misaz/Elector-Contest-Solar-Sensor/11_sensor_sch/SolarTemperatureSensor.pdf

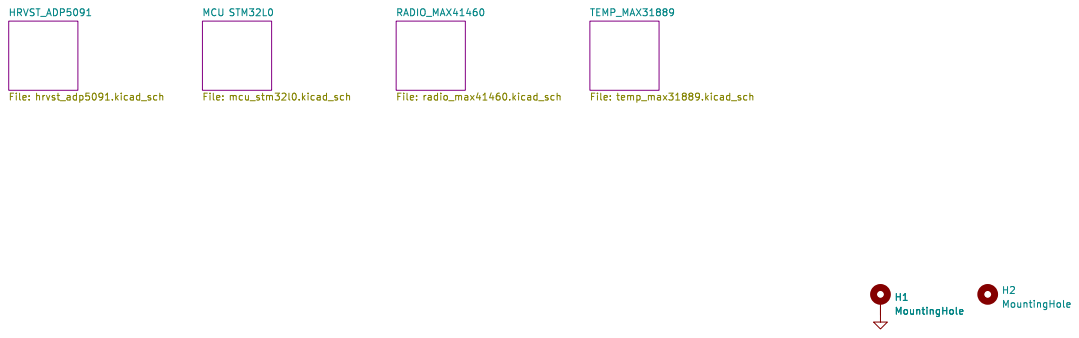
[picture p1: page 1]

Id: 1/5 Title: File: SolarTemperatureSensor.kicad_sch Sheet: /

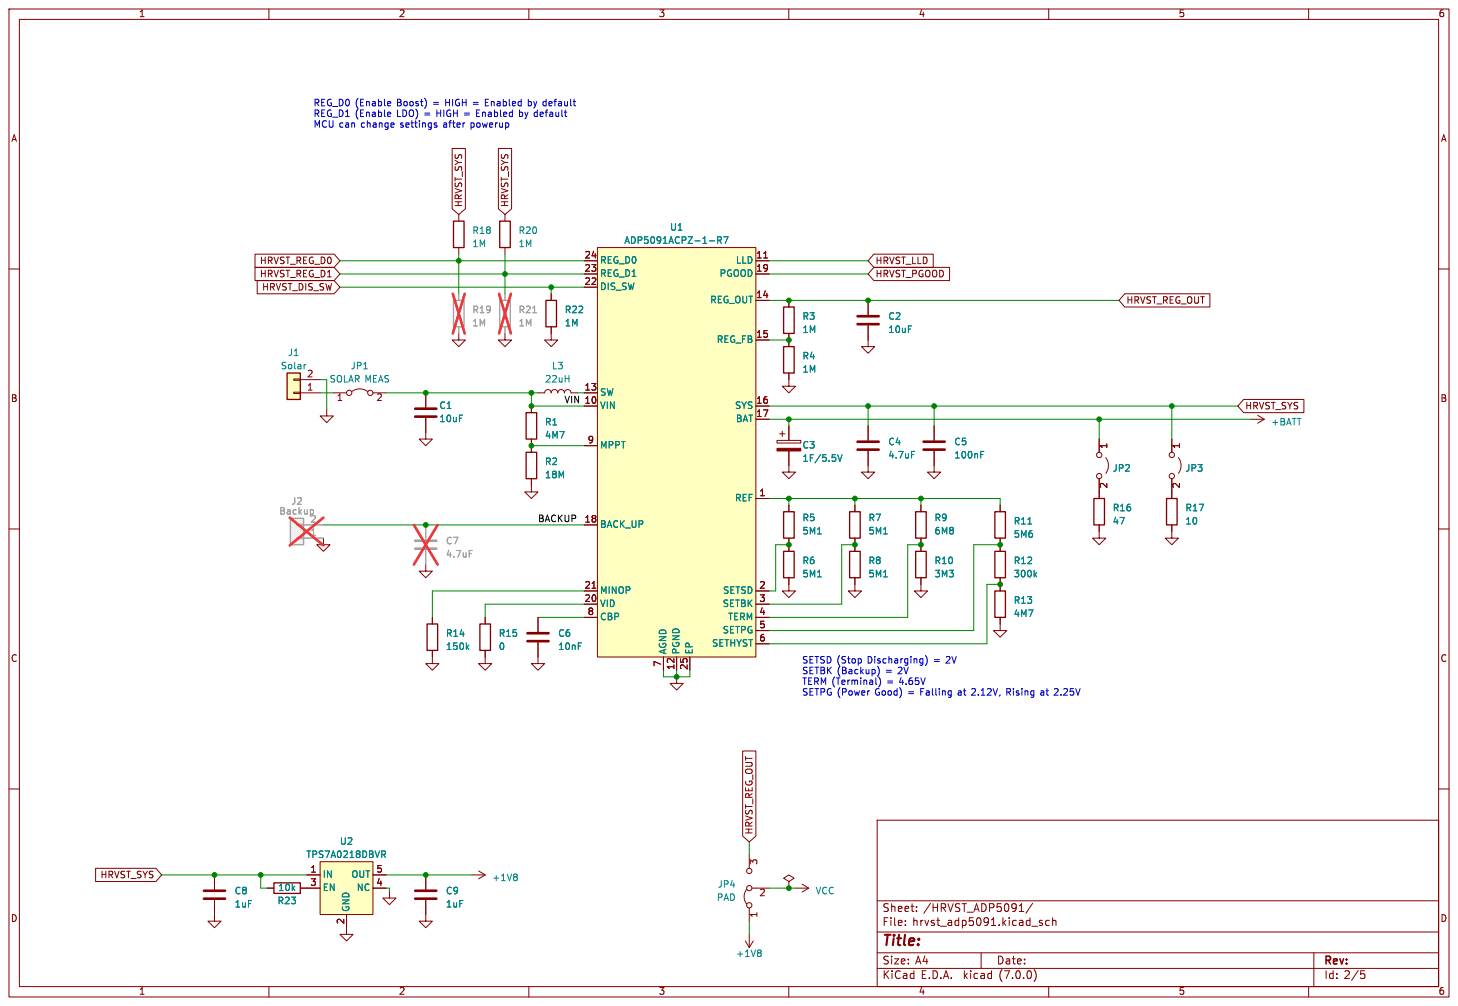
[picture p2: page 2]

SETPG (Power Good) = Falling at 2.12V, Rising at 2.25V R3

Id: 2/5 Title: File: hrvst_adp5091.kicad_sch Sheet: /HRVST_ADP5091/

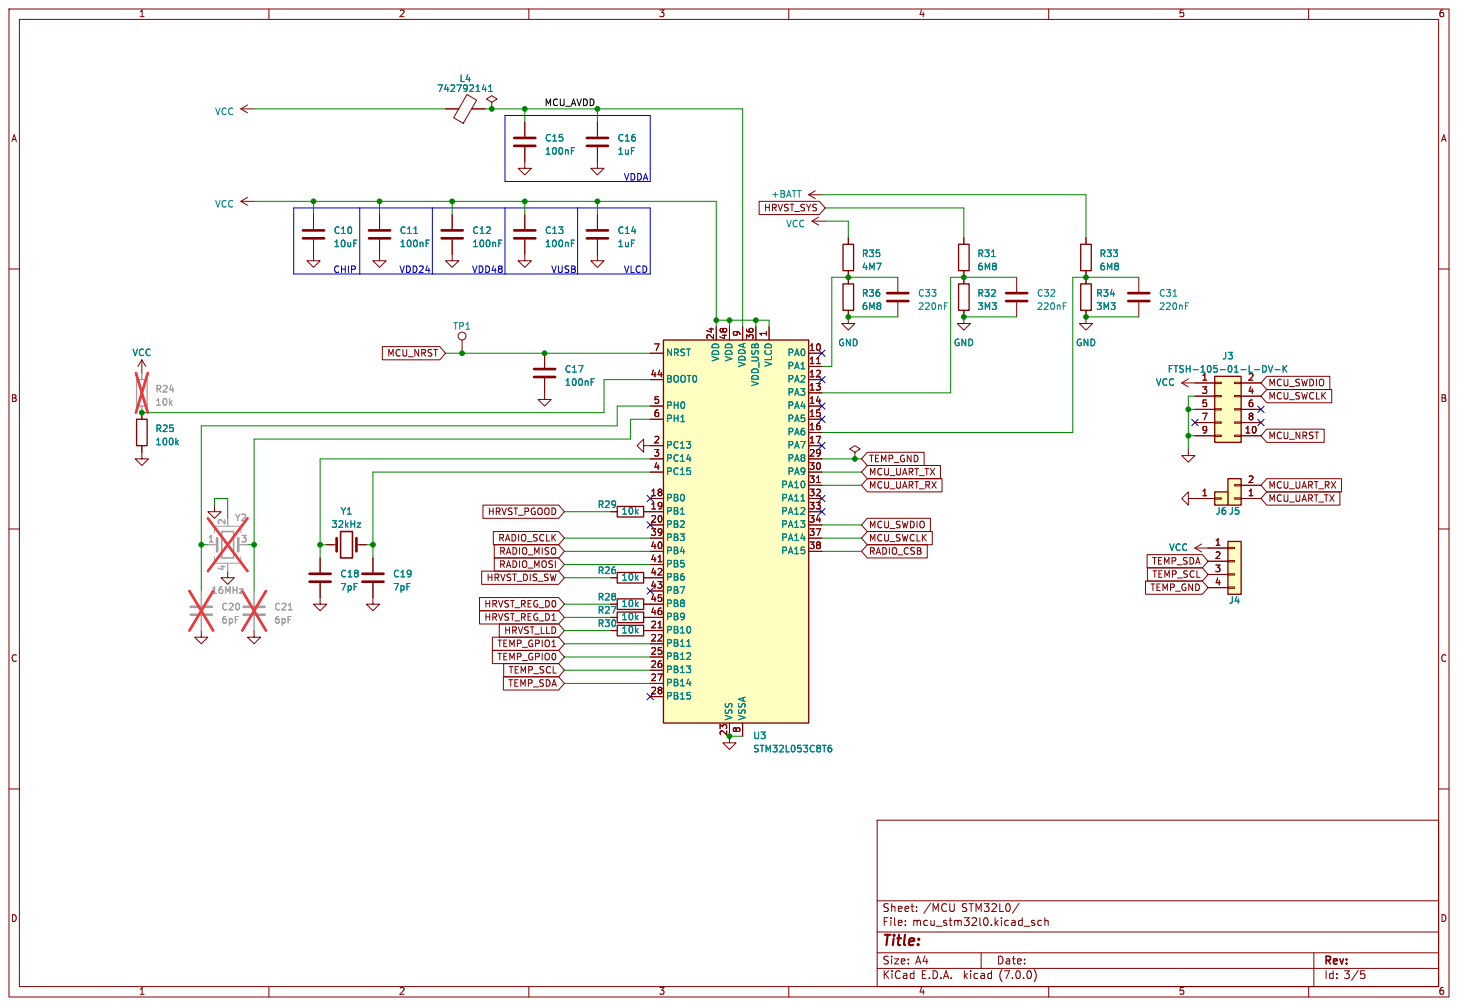
[picture p3: page 3]

1 PA0 10 PA1 11 PA2 12 PA3 13 PA4 14 PA5 15 PA6 16 PA7 17 PB0 18 PB1 19 PC13 2 PB2 20 PB10 21 PB11 22 VSS 23 VDD 24 PB12 25 PB13 26 PB14 27 PB15 28 PA8 29 PC14 3 PA9 30 PA10 31 PA11 32 PA12 33 PA13 34 VDD_USB 36 PA14 37 PA15 38 PB3 39 PC15 4 PB4 40 PB5 41 PB6 42 PB7 43 BOOT0 44 PB8 45 PB9 46 VDD 48 PH0 5 PH1 6 NRST 7 VSSA

Id: 3/5 Title: File: mcu_stm32l0.kicad_sch Sheet: /MCU STM32L0/ Y1

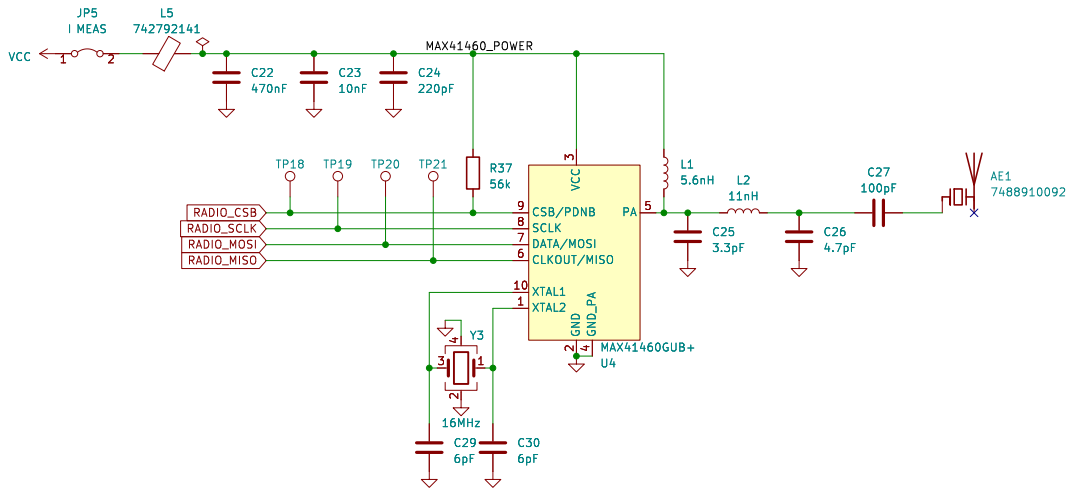
[picture p4: page 4]

4 PA 5 CLKOUT/MISO 6 DATA/MOSI 7 SCLK 8 CSB/PDNB 9 U4 MAX41460GUB+ C25

4 PA 5 CLKOUT/MISO 6 DATA/MOSI 7 SCLK 8 CSB/PDNB 9 C25

Id: 4/5 Title: File: radio_max41460.kicad_sch Sheet: /RADIO_MAX41460/

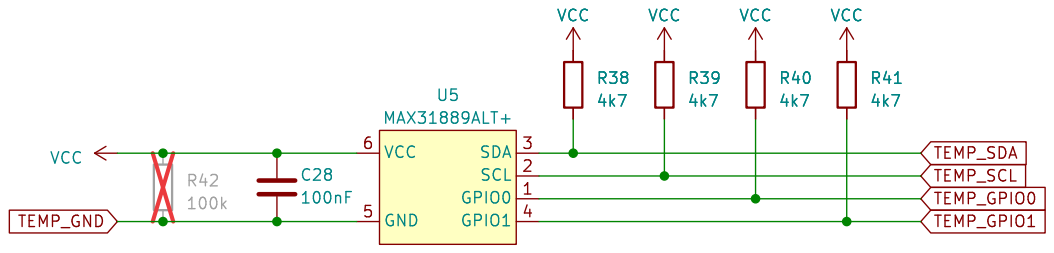
[picture p5: page 5]

Id: 5/5 Title: File: temp_max31889.kicad_sch Sheet: /TEMP_MAX31889/
