misaz/Elector-Contest-Solar-Sensor/10_sensor_kicad/SolarTemperatureSensor.kicad_pcb

## KiCad design 10_sensor_kicad/SolarTemperatureSensor.kicad_pcb (2024-03-01)

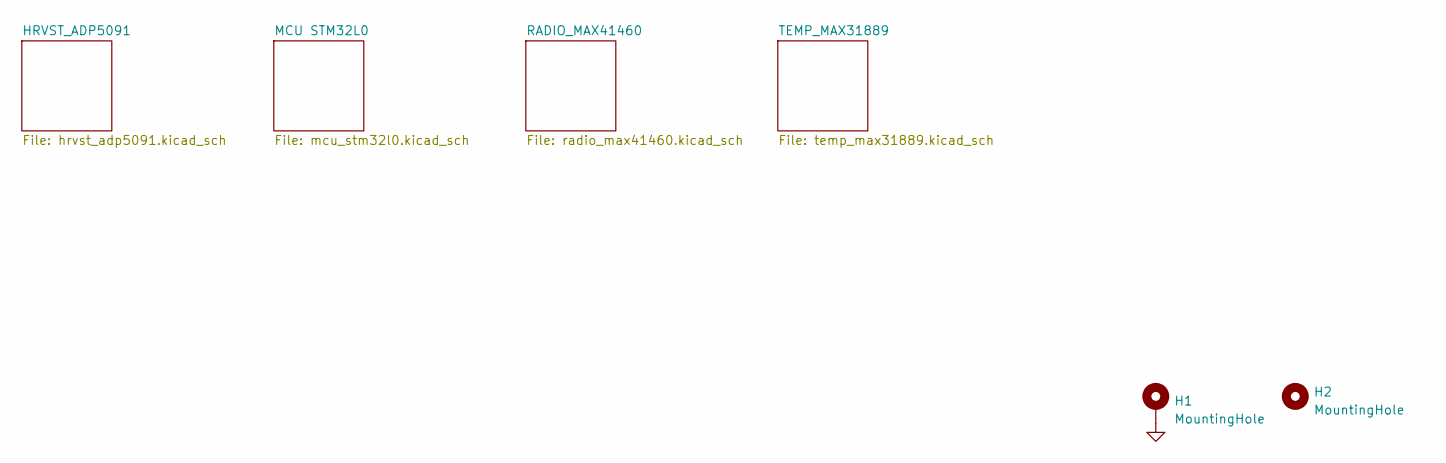
[picture p6: schematic SolarTemperatureSensor.kicad_sch]

Parts:
H1: MountingHole; MountingHole_3.5mm_Pad
H2: MountingHole; MountingHole_3.5mm

Connections:
GND: H1.1; also elsewhere on the board

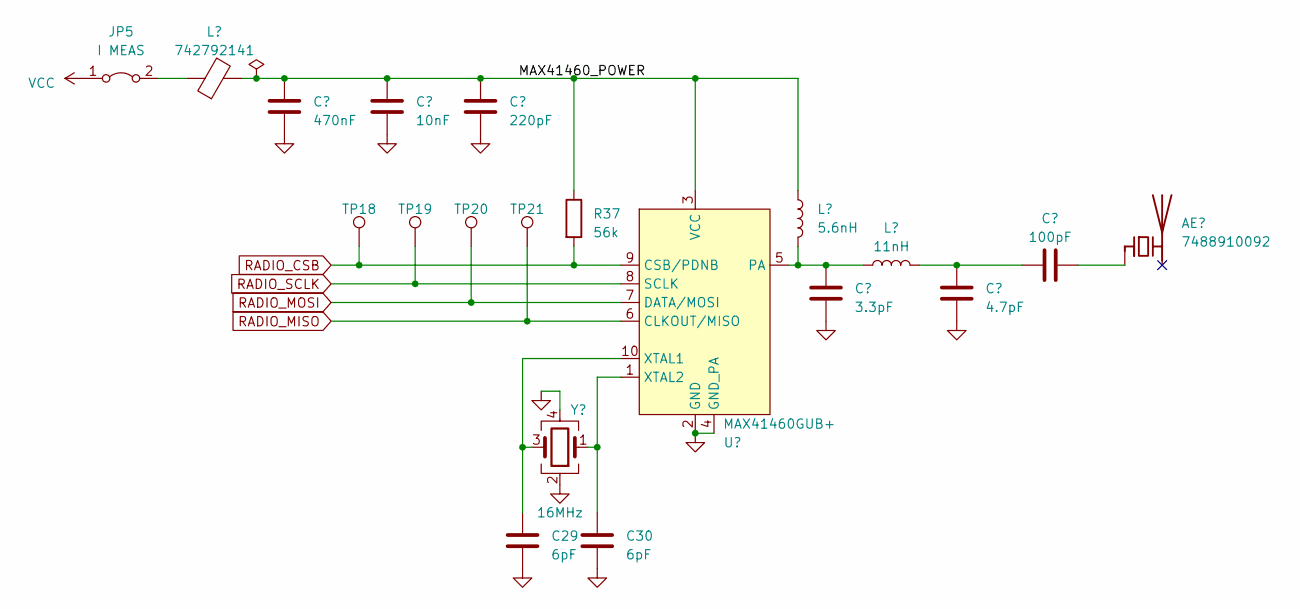
[picture p7: schematic radio_max41460.kicad_sch]

Parts:
AE1: 7488910092
C22: 470nF; C_0603_1608Metric_Pad1.08x0.95mm_HandSolder
C23: 10nF; C_0603_1608Metric_Pad1.08x0.95mm_HandSolder
C24: 220pF; C_0603_1608Metric_Pad1.08x0.95mm_HandSolder
C25: 3.3pF; C_0805_2012Metric_Pad1.18x1.45mm_HandSolder
C26: 4.7pF; C_0805_2012Metric_Pad1.18x1.45mm_HandSolder
C27: 100pF; C_0805_2012Metric_Pad1.18x1.45mm_HandSolder
C29, C30: 6pF; C_0805_2012Metric
JP5: I MEAS; PinHeader_1x02_P2.54mm_Vertical
L1: 5.6nH; L_0603_1608Metric_Pad1.05x0.95mm_HandSolder
L2: 11nH; L_0603_1608Metric_Pad1.05x0.95mm_HandSolder
L5: 742792141; L_1206_3216Metric
R37: 56k; R_0603_1608Metric_Pad0.98x0.95mm_HandSolder
TP18, TP19, TP20, TP21: TestPoint; TestPoint_Pad_D1.0mm
U4: MAX41460GUB+; MAX41460
Y3: 16MHz; Crystal_SMD_2016-4Pin_2.0x1.6mm

Connections:
/RADIO_MAX41460/MAX41460_POWER: C22.1, C23.1, C24.1, L1.1, L5.2, R37.1, U4.3 (VCC)
GND: C22.2, C23.2, C24.2, C25.2, C26.2, C29.2, C30.2, U4.2 (GND), U4.4 (GND_PA), Y3.2, Y3.4; also elsewhere on the board
unnamed: AE1.1 (FEED), C27.2
unnamed: C26.1, C27.1, L2.2
unnamed: JP5.2 (B), L5.1
unnamed: C25.1, L1.2, L2.1, U4.5 (PA)
unnamed: C29.1, U4.10 (XTAL1), Y3.3
unnamed: C30.1, U4.1 (XTAL2), Y3.1
RADIO_CSB: R37.2, TP18.1, U4.9 (CSB/PDNB); also elsewhere on the board
RADIO_MISO: TP21.1, U4.6 (CLKOUT/MISO); also elsewhere on the board
RADIO_MOSI: TP20.1, U4.7 (DATA/MOSI); also elsewhere on the board
RADIO_SCLK: TP19.1, U4.8 (SCLK); also elsewhere on the board
VCC: JP5.1 (A); also elsewhere on the board

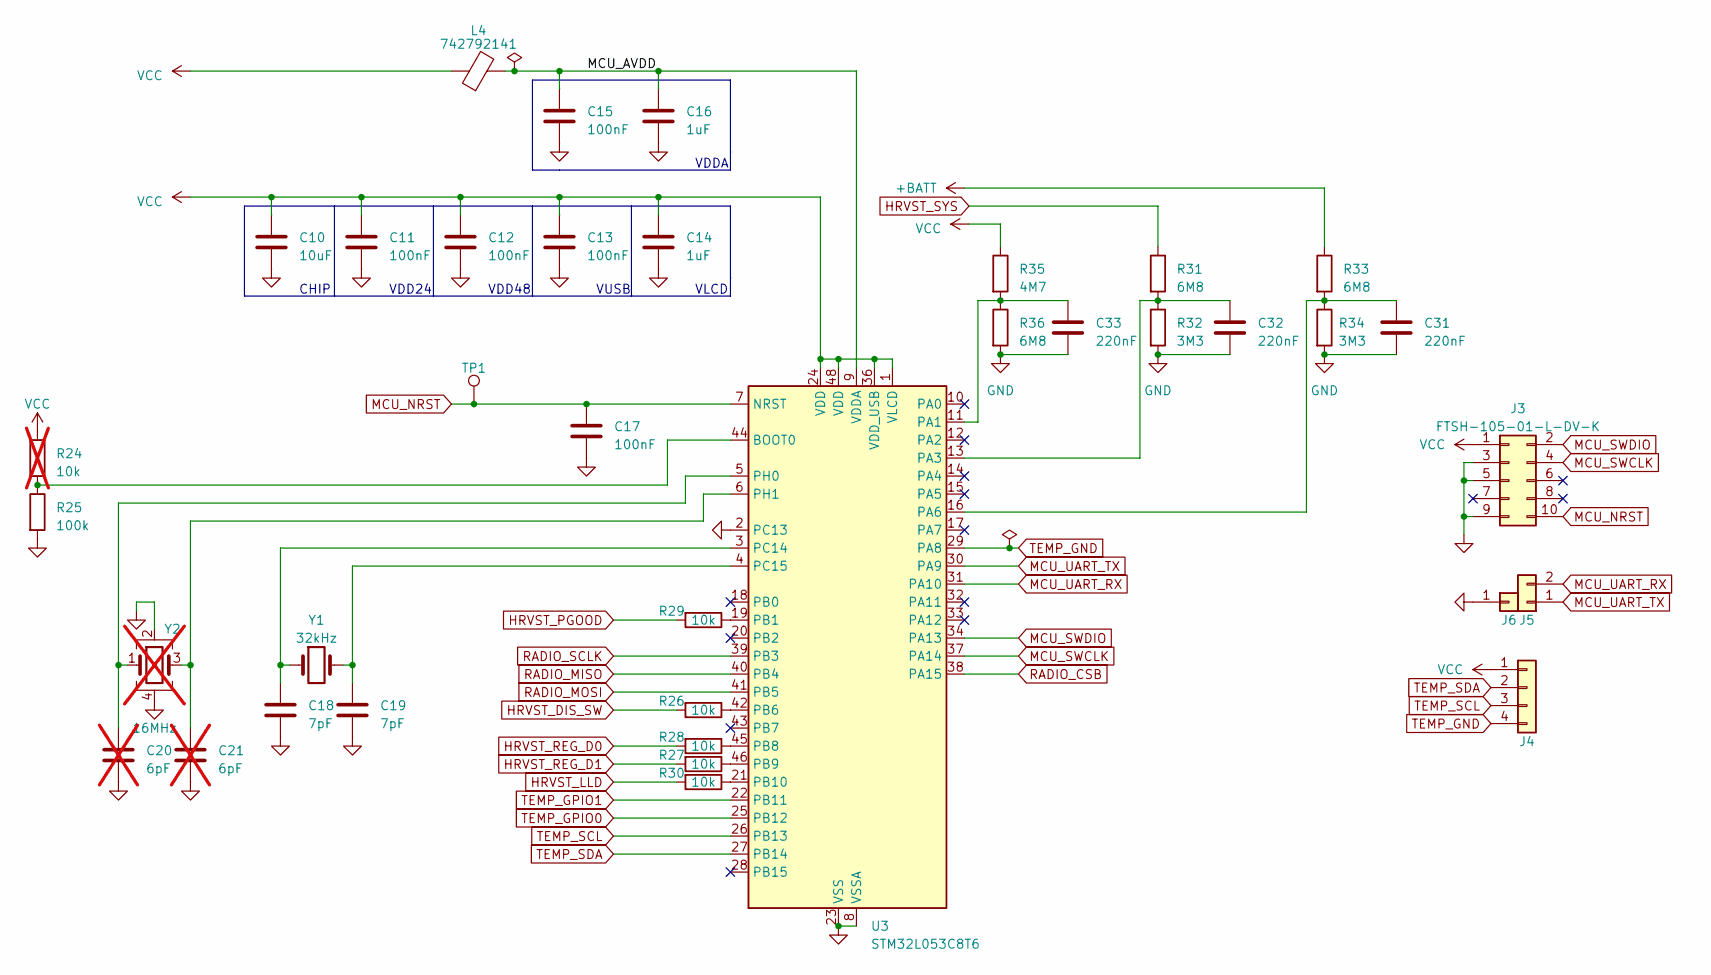
[picture p8: schematic mcu_stm32l0.kicad_sch]

Parts:
C10: 10uF; C_0603_1608Metric_Pad1.08x0.95mm_HandSolder
C11, C12, C13, C15, C17: 100nF; C_0603_1608Metric_Pad1.08x0.95mm_HandSolder
C14, C16: 1uF; C_0603_1608Metric_Pad1.08x0.95mm_HandSolder
C18, C19: 7pF; C_0805_2012Metric
C20, C21: 6pF; C_0805_2012Metric; not fitted
C31, C32, C33: 220nF
J3: FTSH-105-01-L-DV-K; SAMTEC_FTSH-105-XX-X-DV
J4: Conn_01x04; PinHeader_1x04_P2.54mm_Vertical
J5: Conn_01x02; PinHeader_1x02_P2.54mm_Vertical
J6: Conn_01x01; PinHeader_1x01_P2.54mm_Vertical
L4: 742792141; L_1206_3216Metric
R24: 10k; R_0603_1608Metric_Pad0.98x0.95mm_HandSolder; not fitted
R25: 100k; R_0603_1608Metric_Pad0.98x0.95mm_HandSolder
R26, R27, R28, R29, R30: 10k; R_0603_1608Metric_Pad0.98x0.95mm_HandSolder
R31, R33, R36: 6M8; R_0603_1608Metric_Pad0.98x0.95mm_HandSolder
R32, R34: 3M3; R_0603_1608Metric_Pad0.98x0.95mm_HandSolder
R35: 4M7; R_0603_1608Metric_Pad0.98x0.95mm_HandSolder
TP1: TestPoint; TestPoint_Pad_D1.0mm
U3: STM32L053C8T6; LQFP-48_7x7mm_P0.5mm
Y1: 32kHz; Crystal_SMD_3215-2Pin_3.2x1.5mm
Y2: 16MHz; Crystal_SMD_2016-4Pin_2.0x1.6mm; not fitted

Connections:
+BATT: R33.1; also elsewhere on the board
/MCU STM32L0/MCU_AVDD: C15.1, C16.1, L4.2, U3.9 (VDDA)
GND: C10.2, C11.2, C12.2, C13.2, C14.2, C15.2, C16.2, C17.2, C18.2, C19.2, C20.2, C21.2, C31.2, C32.2, C33.2, J3.3, J3.5, J3.9, J6.1, R25.2, R32.2, R34.2, R36.2, U3.2 (PC13), U3.8 (VSSA), U3.23 (VSS), U3.35 (VSS), U3.47 (VSS), Y2.2, Y2.4; also elsewhere on the board
HRVST_DIS_SW: R26.2; also elsewhere on the board
HRVST_LLD: R30.2; also elsewhere on the board
HRVST_PGOOD: R29.2; also elsewhere on the board
HRVST_REG_D0: R28.2; also elsewhere on the board
HRVST_REG_D1: R27.2; also elsewhere on the board
HRVST_SYS: R31.1; also elsewhere on the board
MCU_NRST: C17.1, J3.10, TP1.1, U3.7 (NRST)
MCU_SWCLK: J3.4, U3.37 (PA14)
MCU_SWDIO: J3.2, U3.34 (PA13)
MCU_UART_RX: J5.2, U3.31 (PA10)
MCU_UART_TX: J5.1, U3.30 (PA9)
unnamed: R24.2, R25.1, U3.44 (BOOT0)
unnamed: C33.1, R35.2, R36.1, U3.11 (PA1)
unnamed: C32.1, R31.2, R32.1, U3.13 (PA3)
unnamed: C31.1, R33.2, R34.1, U3.16 (PA6)
unnamed: R29.1, U3.19 (PB1)
unnamed: R26.1, U3.42 (PB6)
unnamed: R28.1, U3.45 (PB8)
unnamed: R27.1, U3.46 (PB9)
unnamed: R30.1, U3.21 (PB10)
unnamed: C18.1, U3.3 (PC14), Y1.1
unnamed: C19.1, U3.4 (PC15), Y1.2
unnamed: C20.1, U3.5 (PH0), Y2.1
unnamed: C21.1, U3.6 (PH1), Y2.3
RADIO_CSB: U3.38 (PA15); also elsewhere on the board
RADIO_MISO: U3.40 (PB4); also elsewhere on the board
RADIO_MOSI: U3.41 (PB5); also elsewhere on the board
RADIO_SCLK: U3.39 (PB3); also elsewhere on the board
TEMP_GND: J4.4, U3.29 (PA8); also elsewhere on the board
TEMP_GPIO0: U3.25 (PB12); also elsewhere on the board
TEMP_GPIO1: U3.22 (PB11); also elsewhere on the board
TEMP_SCL: J4.3, U3.26 (PB13); also elsewhere on the board
TEMP_SDA: J4.2, U3.27 (PB14); also elsewhere on the board
VCC: C10.1, C11.1, C12.1, C13.1, C14.1, J3.1, J4.1, L4.1, R24.1, R35.1, U3.1 (VLCD), U3.24 (VDD), U3.36 (VDD_USB), U3.48 (VDD); also elsewhere on the board

Notes on the sheet:
VDD48
CHIP
VUSB
VDD24
VLCD
VDDA

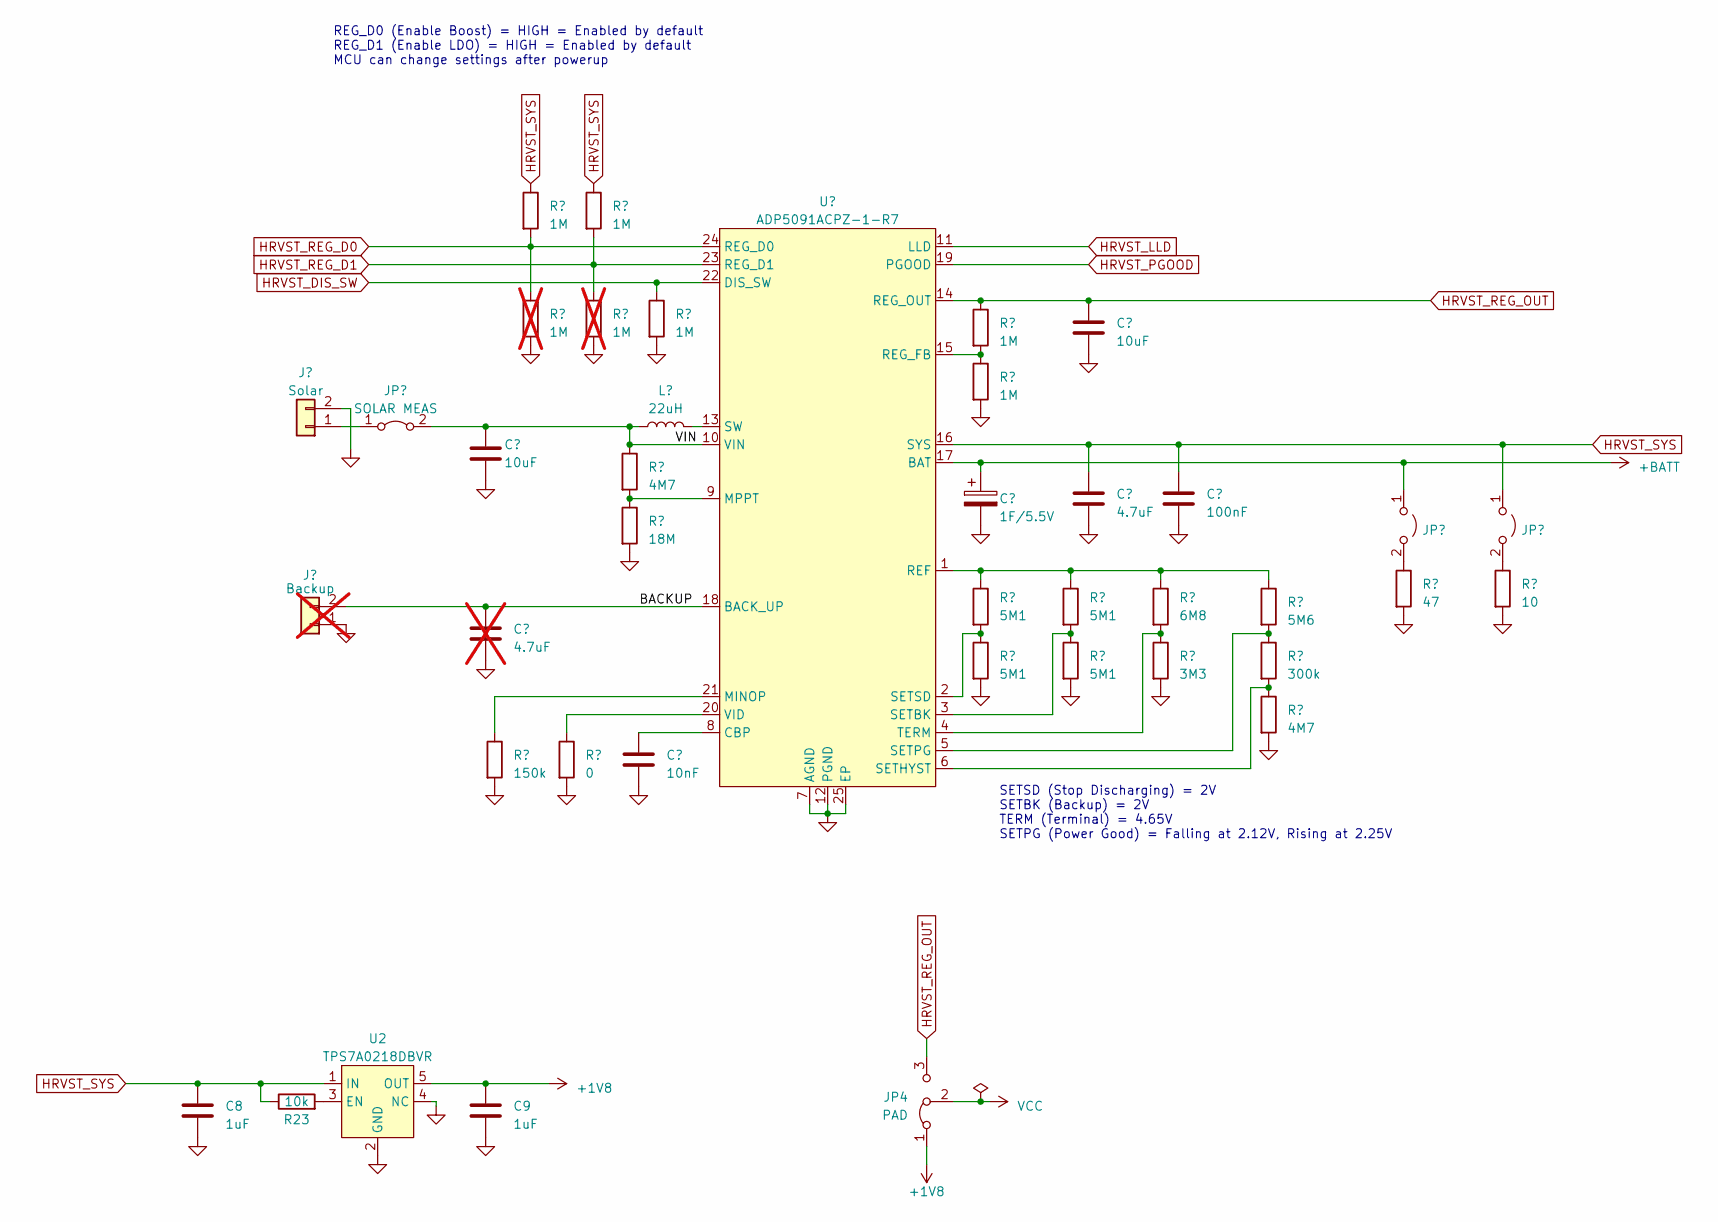
[picture p9: schematic hrvst_adp5091.kicad_sch]

Parts:
C1, C2: 10uF; C_0603_1608Metric_Pad1.08x0.95mm_HandSolder
C3: 1F/5.5V; SCMR18C105PRBA0
C4: 4.7uF; C_0603_1608Metric_Pad1.08x0.95mm_HandSolder
C5: 100nF; C_0603_1608Metric_Pad1.08x0.95mm_HandSolder
C6: 10nF; C_0603_1608Metric_Pad1.08x0.95mm_HandSolder
C7: 4.7uF; C_0603_1608Metric_Pad1.08x0.95mm_HandSolder; not fitted
C8, C9: 1uF; C_0603_1608Metric_Pad1.08x0.95mm_HandSolder
J1: Solar; VN02A1500000G
J2: Backup; VN02A1500000G; not fitted
JP1: SOLAR MEAS; PinHeader_1x02_P2.54mm_Vertical
JP2, JP3: BAT DISCHARGE; PinHeader_1x02_P2.54mm_Vertical
JP4: PAD; SolderJumper-3_P1.3mm_Open_RoundedPad1.0x1.5mm
L3: 22uH; DJNR6045
R1, R13: 4M7; R_0603_1608Metric_Pad0.98x0.95mm_HandSolder
R2: 18M; R_0603_1608Metric_Pad0.98x0.95mm_HandSolder
R3, R4, R18, R20, R22: 1M; R_0603_1608Metric_Pad0.98x0.95mm_HandSolder
R5, R6, R7, R8: 5M1; R_0603_1608Metric_Pad0.98x0.95mm_HandSolder
R9: 6M8; R_0603_1608Metric_Pad0.98x0.95mm_HandSolder
R10: 3M3; R_0603_1608Metric_Pad0.98x0.95mm_HandSolder
R11: 5M6; R_0603_1608Metric_Pad0.98x0.95mm_HandSolder
R12: 300k; R_0603_1608Metric_Pad0.98x0.95mm_HandSolder
R14: 150k; R_0603_1608Metric_Pad0.98x0.95mm_HandSolder
R15: 0; R_0603_1608Metric_Pad0.98x0.95mm_HandSolder
R16: 47; R_0603_1608Metric_Pad0.98x0.95mm_HandSolder
R17: 10; R_0603_1608Metric_Pad0.98x0.95mm_HandSolder
R19, R21: 1M; R_0603_1608Metric_Pad0.98x0.95mm_HandSolder; not fitted
R23: 10k; R_0603_1608Metric_Pad0.98x0.95mm_HandSolder
U1: ADP5091ACPZ-1-R7; ADP5091ACPZ-1-R7_ADI-M
U2: TPS7A0218DBVR; SOT-23-5_HandSoldering

Connections:
+1V8: C9.1, JP4.1 (A), U2.5 (OUT)
+BATT: C3.1, JP2.1 (A), U1.17 (BAT); also elsewhere on the board
/HRVST_ADP5091/BACKUP: C7.1, J2.2, U1.18 (BACK_UP)
/HRVST_ADP5091/VIN: C1.1, JP1.2 (B), L3.1, R1.1, U1.10 (VIN)
GND: C1.2, C2.2, C3.2, C4.2, C5.2, C6.2, C7.2, C8.2, C9.2, J1.2, J2.1, R2.2, R4.2, R6.2, R8.2, R10.2, R13.2, R14.2, R15.2, R16.2, R17.2, R19.2, R21.2, R22.2, U1.7 (AGND), U1.12 (PGND), U1.25 (EP), U2.2 (GND), U2.4 (NC); also elsewhere on the board
HRVST_DIS_SW: R22.1, U1.22 (DIS_SW); also elsewhere on the board
HRVST_LLD: U1.11 (LLD); also elsewhere on the board
HRVST_PGOOD: U1.19 (PGOOD); also elsewhere on the board
HRVST_REG_D0: R18.2, R19.1, U1.24 (REG_D0); also elsewhere on the board
HRVST_REG_D1: R20.2, R21.1, U1.23 (REG_D1); also elsewhere on the board
HRVST_REG_OUT: C2.1, JP4.3 (B), R3.1, U1.14 (REG_OUT)
HRVST_SYS: C4.1, C5.1, C8.1, JP3.1 (A), R18.1, R20.1, R23.1, U1.16 (SYS), U2.1 (IN); also elsewhere on the board
unnamed: J1.1, JP1.1 (A)
unnamed: JP2.2 (B), R16.1
unnamed: JP3.2 (B), R17.1
unnamed: C6.1, U1.8 (CBP)
unnamed: R14.1, U1.21 (MINOP)
unnamed: R1.2, R2.1, U1.9 (MPPT)
unnamed: R5.1, R7.1, R9.1, R11.1, U1.1 (REF)
unnamed: R3.2, R4.1, U1.15 (REG_FB)
unnamed: R7.2, R8.1, U1.3 (SETBK)
unnamed: R12.2, R13.1, U1.6 (SETHYST)
unnamed: R11.2, R12.1, U1.5 (SETPG)
unnamed: R5.2, R6.1, U1.2 (SETSD)
unnamed: L3.2, U1.13 (SW)
unnamed: R9.2, R10.1, U1.4 (TERM)
unnamed: R15.1, U1.20 (VID)
unnamed: R23.2, U2.3 (EN)
VCC: JP4.2 (C); also elsewhere on the board

Notes on the sheet:
SETSD (Stop Discharging) = 2V SETBK (Backup) = 2V TERM (Terminal) = 4.65V SETPG (Power Good) = Falling at 2.12V, Rising at 2.25V
REG_D0 (Enable Boost) = HIGH = Enabled by default REG_D1 (Enable LDO) = HIGH = Enabled by default MCU can change settings after powerup

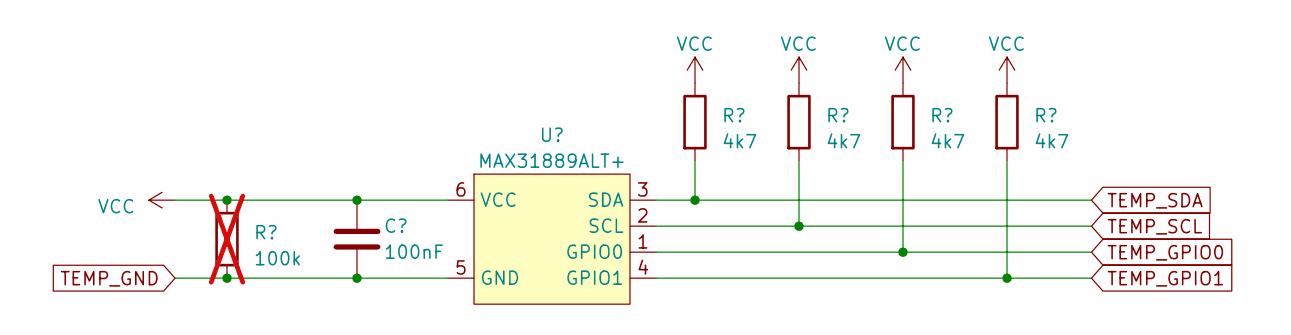
[picture p10: schematic temp_max31889.kicad_sch]

Parts:
C28: 100nF; C_0603_1608Metric_Pad1.08x0.95mm_HandSolder
R38, R39, R40, R41: 4k7; R_0603_1608Metric_Pad0.98x0.95mm_HandSolder
R42: 100k; R_0603_1608Metric_Pad0.98x0.95mm_HandSolder; not fitted
U5: MAX31889ALT+; MAXIM-uDFN6

Connections:
TEMP_GND: C28.2, R42.2, U5.5 (GND); also elsewhere on the board
TEMP_GPIO0: R40.2, U5.1 (GPIO0); also elsewhere on the board
TEMP_GPIO1: R41.2, U5.4 (GPIO1); also elsewhere on the board
TEMP_SCL: R39.2, U5.2 (SCL); also elsewhere on the board
TEMP_SDA: R38.2, U5.3 (SDA); also elsewhere on the board
VCC: C28.1, R38.1, R39.1, R40.1, R41.1, R42.1, U5.6 (VCC); also elsewhere on the board

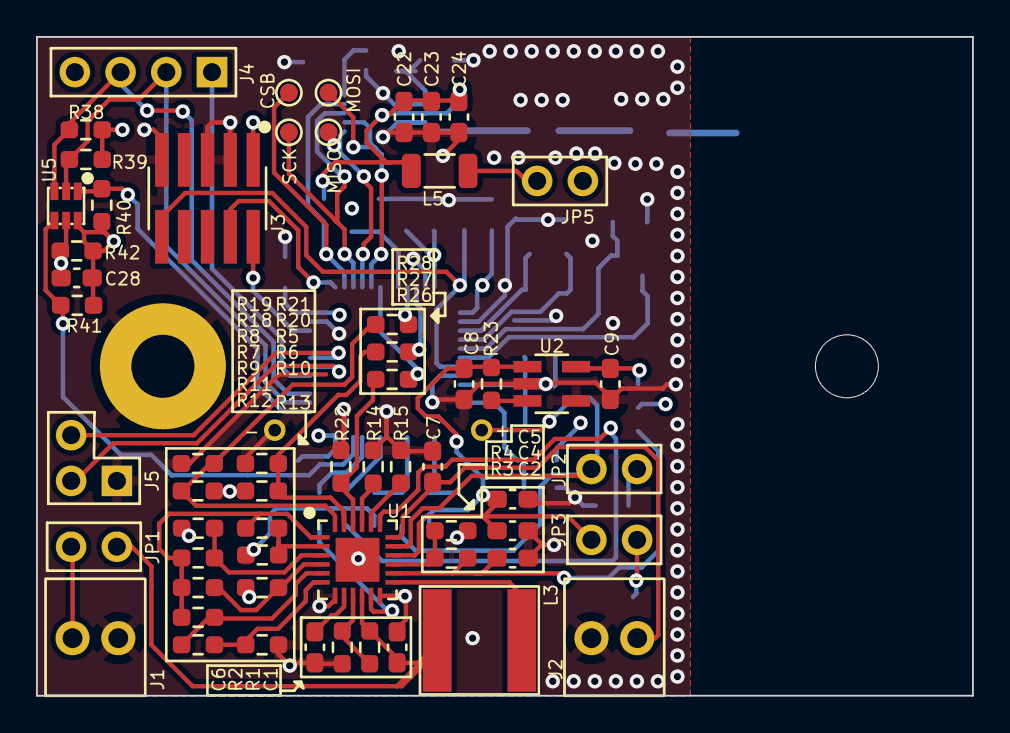
[picture p11: board SolarTemperatureSensor.kicad_pcb from above]

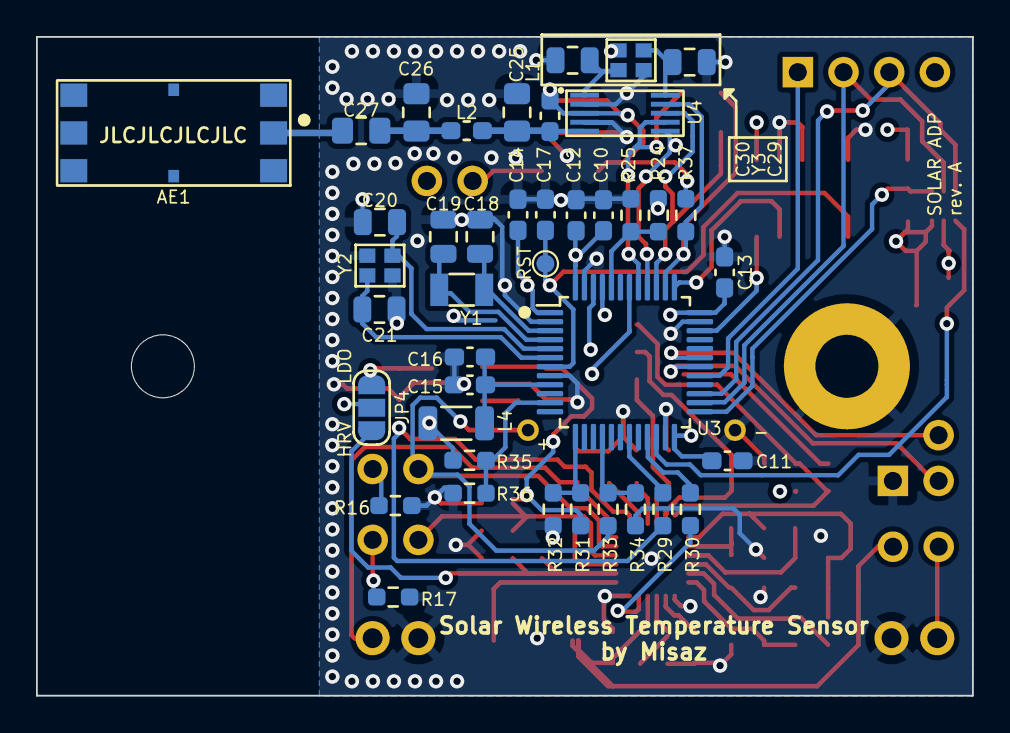
[picture p12: board SolarTemperatureSensor.kicad_pcb from below]

Board: 4 copper layers, 52.0 x 36.6 mm, 104 parts (41 on the bottom side), 64 nets.
