misaz/Elector-Contest-Solar-Sensor/20_sensor_stm32l053_fw/SolarTemperatureSensor_V2/Core/Inc/main.h

#define UNUSED11_Pin GPIO_PIN_13
#define UNUSED11_GPIO_Port GPIOC
#define XTAL_16M_UNUSED1_Pin GPIO_PIN_0
#define XTAL_16M_UNUSED1_GPIO_Port GPIOH
#define XTAL_16M_UNUSED2_Pin GPIO_PIN_1
#define XTAL_16M_UNUSED2_GPIO_Port GPIOH
#define UNUSED0_Pin GPIO_PIN_0
#define UNUSED0_GPIO_Port GPIOA
#define UNUSED1_Pin GPIO_PIN_1
#define UNUSED1_GPIO_Port GPIOA
#define UNUSED2_Pin GPIO_PIN_2
#define UNUSED2_GPIO_Port GPIOA
#define VBATT_ADC_EN_Pin GPIO_PIN_3
#define VBATT_ADC_EN_GPIO_Port GPIOA
#define UNUSED3_Pin GPIO_PIN_4
#define UNUSED3_GPIO_Port GPIOA
#define UNUSED4_Pin GPIO_PIN_5
#define UNUSED4_GPIO_Port GPIOA
#define VBATT_ADC_IN_Pin GPIO_PIN_6
#define VBATT_ADC_IN_GPIO_Port GPIOA
#define UNUSED5_Pin GPIO_PIN_7
#define UNUSED5_GPIO_Port GPIOA
#define UNUSED8_Pin GPIO_PIN_0
#define UNUSED8_GPIO_Port GPIOB
#define HRVST_PGOOD_Pin GPIO_PIN_1
#define HRVST_PGOOD_GPIO_Port GPIOB
#define UNUSED9_Pin GPIO_PIN_2
#define UNUSED9_GPIO_Port GPIOB
#define HRVST_LLD_Pin GPIO_PIN_10
#define HRVST_LLD_GPIO_Port GPIOB
#define TEMP_GPIO1_Pin GPIO_PIN_11
#define TEMP_GPIO1_GPIO_Port GPIOB
#define TEMP_GPIO0_Pin GPIO_PIN_12
#define TEMP_GPIO0_GPIO_Port GPIOB
#define UNUSED11_GND_Pin GPIO_PIN_15
#define UNUSED11_GND_GPIO_Port GPIOB
#define TEMP_GND_Pin GPIO_PIN_8
#define TEMP_GND_GPIO_Port GPIOA
#define DBG1_Pin GPIO_PIN_9
#define DBG1_GPIO_Port GPIOA
#define DBG2_Pin GPIO_PIN_10
#define DBG2_GPIO_Port GPIOA
#define UNUSED6_GND_Pin GPIO_PIN_11
#define UNUSED6_GND_GPIO_Port GPIOA
#define UNUSED7_GND_Pin GPIO_PIN_12
#define UNUSED7_GND_GPIO_Port GPIOA
#define RADIO_CSB_Pin GPIO_PIN_15
#define RADIO_CSB_GPIO_Port GPIOA
#define RADIO_SCLK_Pin GPIO_PIN_3
#define RADIO_SCLK_GPIO_Port GPIOB
#define RADIO_MISO_Pin GPIO_PIN_4
#define RADIO_MISO_GPIO_Port GPIOB
#define RADIO_MOSI_Pin GPIO_PIN_5
#define RADIO_MOSI_GPIO_Port GPIOB
#define HRVST_DIS_SW_Pin GPIO_PIN_6
#define HRVST_DIS_SW_GPIO_Port GPIOB
#define UNUSED10_GND_Pin GPIO_PIN_7
#define UNUSED10_GND_GPIO_Port GPIOB
#define HRVST_REG_D0_Pin GPIO_PIN_8
#define HRVST_REG_D0_GPIO_Port GPIOB
#define HRVST_REG_D1_Pin GPIO_PIN_9
#define HRVST_REG_D1_GPIO_Port GPIOB
