misaz/Elector-Contest-Solar-Sensor/20_sensor_stm32l053_fw/SolarTemperatureSensor_V2/Core/Src/PacketEncoder.h

#ifndef PACKET_ENCODER_H_
#define PACKET_ENCODER_H_

#include "MeasurementData.h"
#include "PacketId.h"

#include <stdint.h>
#include <stddef.h>

int PacketEncoder_EncodeNewDataPacket(uint8_t *buffer, size_t bufferSize, MeasurementData *data, PacketId* packetId, int retransmissionNumber);

#endif
