misaz/Elector-Contest-Solar-Sensor/20_sensor_stm32l053_fw/SolarTemperatureSensor_V2/Core/Src/PacketId.h

#ifndef PACKET_ID_H_
#define PACKET_ID_H_

#include <stdint.h>

typedef struct {
	uint16_t bootId;
	uint16_t packetCounter;
} PacketId;

void PacketId_Init(PacketId* id);
void PacketId_Increment(PacketId* id);

#endif
