misaz/Elector-Contest-Solar-Sensor/20_sensor_stm32l053_fw/SolarTemperatureSensor_V2/Core/Src/Security.h

#ifndef SECURITY_H_
#define SECURITY_H_

#include <stdint.h>
#include <stddef.h>

int Security_Init();

int Security_EncryptBlock(uint8_t *plaintext, uint8_t *encrypted, size_t plaintextSize);

uint32_t Security_GetDeviceId();
uint16_t Security_GenerateBootId();

#endif
