misaz/Elector-Contest-Solar-Sensor/20_sensor_stm32l053_fw/SolarTemperatureSensor_V2/Core/Src/VoltageMonitor.h

#ifndef VOLTAGEMONITOR_H_
#define VOLTAGEMONITOR_H_

#include <stdint.h>

typedef struct {
	int16_t batteryVoltage;
	int16_t vccVoltage;
} VoltageMonitor_Voltages;

int VoltageMonitor_GetVoltages(VoltageMonitor_Voltages* voltages);

#endif
