misaz/Elector-Contest-Solar-Sensor/(notices)

Notices in the files:
20_sensor_stm32l053_fw/SolarTemperatureSensor_V2/Core/Inc/main.h:
Copyright (c) 2023 STMicroelectronics.
All rights reserved.
This software is licensed under terms that can be found in the LICENSE file
